trfiladelfo/tm4c123g-communication-expansion-board/FW/Eclipse_Workspace/CAN_drv_multipleRX_example/ReadME.txt

Eclipse and GNU-Tools for ARM Embedded processors are set following the readings below properly modified to work with EK-TM4C123GXL:

1-http://kernelhacks.blogspot.it/2012/11/the-complete-tutorial-for-stellaris.html
2-http://kernelhacks.blogspot.it/2012/11/the-complete-tutorial-for-stellaris_23.html
3-http://kernelhacks.blogspot.it/2012/11/the-complete-tutorial-for-stellaris_25.html

OCD is set following also this reading:

4-http://processors.wiki.ti.com/index.php/Stellaris_Launchpad_with_OpenOCD_and_Linux
