trfiladelfo/tm4c123g-communication-expansion-board/Kicad_Manuals/BYOBGettingStartedPack/Design/BoosterPack_considerations.PNG

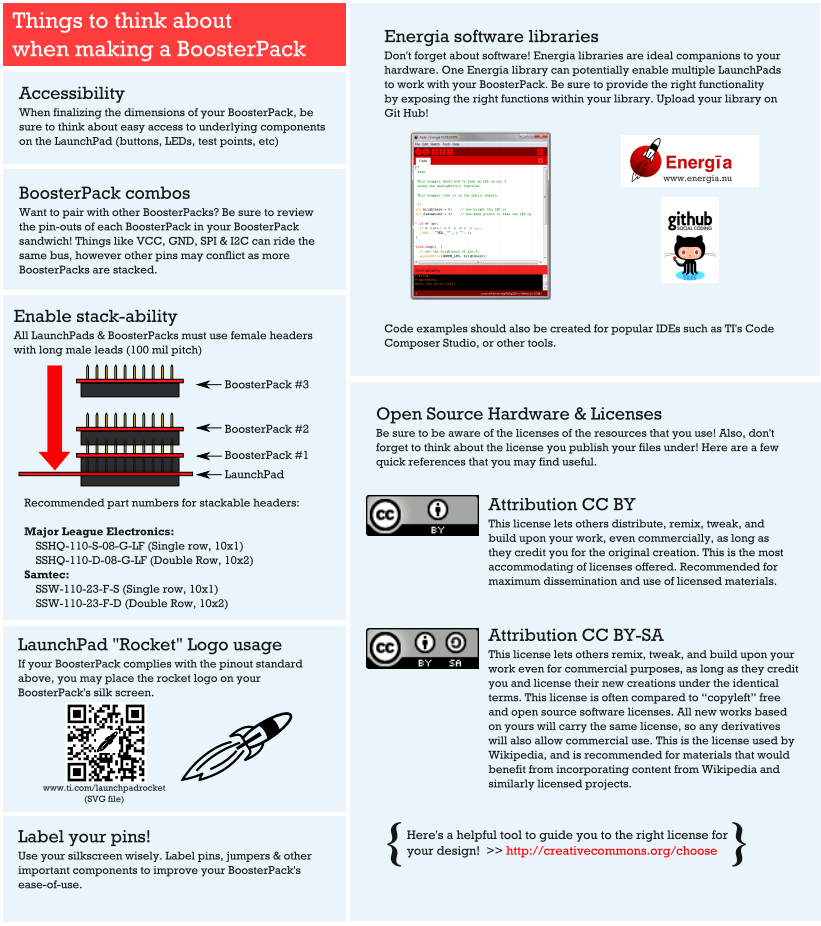
Kicad_Manuals/BYOBGettingStartedPack/Design/BoosterPack_considerations.PNG
