trfiladelfo/tm4c123g-communication-expansion-board/Kicad_Manuals/BYOBGettingStartedPack/Design/BoosterPack_Standard.png

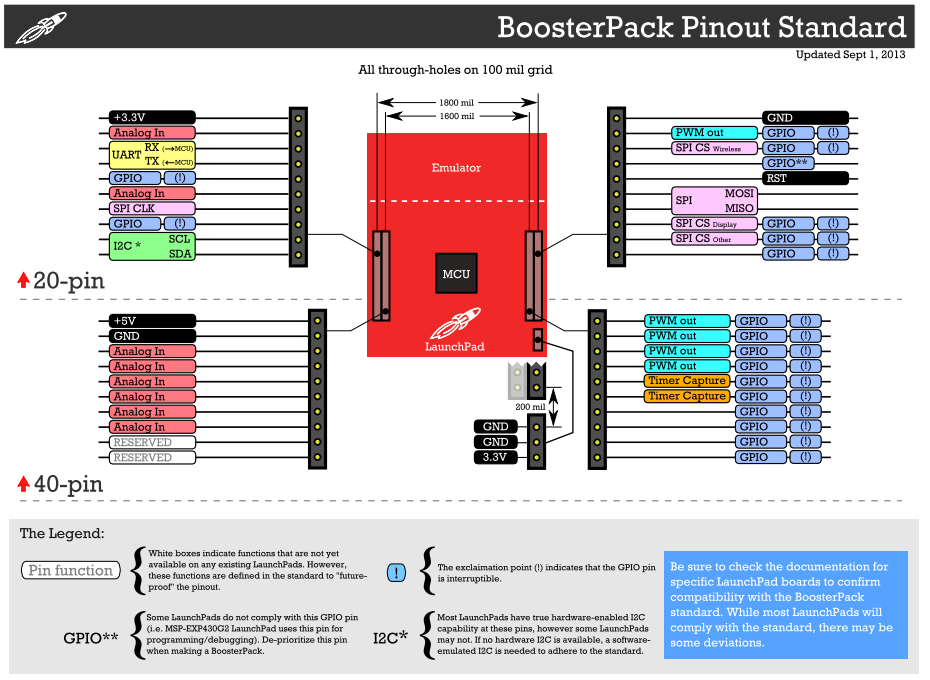
Kicad_Manuals/BYOBGettingStartedPack/Design/BoosterPack_Standard.png
