trfiladelfo/tm4c123g-communication-expansion-board/Kicad_Manuals/BYOBGettingStartedPack/Design/BOM Template and Examples/PCB Assembly Express BOM.XLS

 |  |  | Bill of Materials
 | Customer Project Name:
 | Quote Number:
 | Date
 | Customer Name
 | Company
 | Address 1
 | Address 2
 | City
 | State
 | Zip code
Item | Qty | Reference | Description | Footprint | Type | Manufacturer | Manufacturer Part # | PCB AE Supplies | Vendor | Vendor Part # | Availibility | Min Order Quantity | Order Quantity | Price Each | Ext Price |  | price each | ext price
 |  |  |  |  |  |  |  |  |  |  |  |  |  |  | 0
 |  |  |  |  |  |  |  |  |  |  |  |  |  |  | 0
 |  |  |  |  |  |  |  |  |  |  |  |  |  |  | 0
 |  |  |  |  |  |  |  |  |  |  |  |  |  |  | 0
 |  |  |  |  |  |  |  |  |  |  |  |  |  |  | 0
 |  |  |  |  |  |  |  |  |  |  |  |  |  |  | 0
 |  |  |  |  |  |  |  |  |  |  |  |  |  |  | 0
 |  |  |  |  |  |  |  |  |  |  |  |  |  |  | 0
 |  |  |  |  |  |  |  |  |  |  |  |  |  |  | 0
 |  |  |  |  |  |  |  |  |  |  |  |  |  |  | 0
 |  |  |  |  |  |  |  |  |  |  |  |  |  |  | 0
 |  |  |  |  |  |  |  |  |  |  |  |  |  |  | 0
 |  |  |  |  |  |  |  |  |  |  |  |  |  |  | 0
 |  |  |  |  |  |  |  |  |  |  |  |  |  |  | 0
 |  |  |  |  |  |  |  |  |  |  |  |  |  |  | 0
 |  |  |  |  |  |  |  |  |  |  |  |  |  |  | 0
 |  |  |  |  |  |  |  |  |  |  |  |  |  |  | 0
 |  |  |  |  |  |  |  |  |  |  |  |  |  |  | 0
 |  |  |  |  |  |  |  |  |  |  |  |  |  |  | 0
 |  |  |  |  |  |  |  |  |  |  |  |  |  |  | 0
 |  |  |  |  |  |  |  |  |  |  |  |  |  |  | 0
 |  |  |  |  |  |  |  |  |  |  |  |  |  |  | 0
 |  |  |  |  |  |  |  |  |  |  |  |  |  |  | 0
 |  |  |  |  |  |  |  |  |  |  |  |  |  |  | 0
end
 |  |  |  |  |  |  |  |  |  |  |  |  |  |  | 0
 | Board Totals
 |  | 0 | Total Line Items
 |  | 0 | SMT
 |  | 0 | Thru-hole
 |  | 0 | Fine Pitch
 |  | 0 | BGA
 |  | 0 | Do Not Stuff
 |  | 0 | Total Parts Placements
 | Footprint Key:
 | smt | Surface Mount Technology parts
 | fine | Fine pitch parts
 | bga | Ball Grid Array or orher parts requiring X-Ray inspection
 | thru | Thru-Hole technology parts
 | dns | Do not stuff
 | For Kitted projects columns A-F are required
 | For Partial Kitted projects column I is required
 | For Turn-Key or Partial Kitted projects columns G&H or J&K are also required
 |  |  |  |  |  |  |  |  |  |  |  |  |  |  |  | 0.00
 |  |  |  |  |  |  |  |  |  |  |  |  |  |  |  | 0
