trfiladelfo/tm4c123g-communication-expansion-board/Kicad_Manuals/BYOBGettingStartedPack/Design/BOM Template and Examples/40-Pin-LaunchPad-BoosterPack-Template.csv

Reference | Description | Quantity
J1/J3 J4/J2 |  | 2
