trfiladelfo/tm4c123g-communication-expansion-board/KiCAD_ExpansionBoard/LaunchPad_Logo/LaunchPad_Rocket.pdf

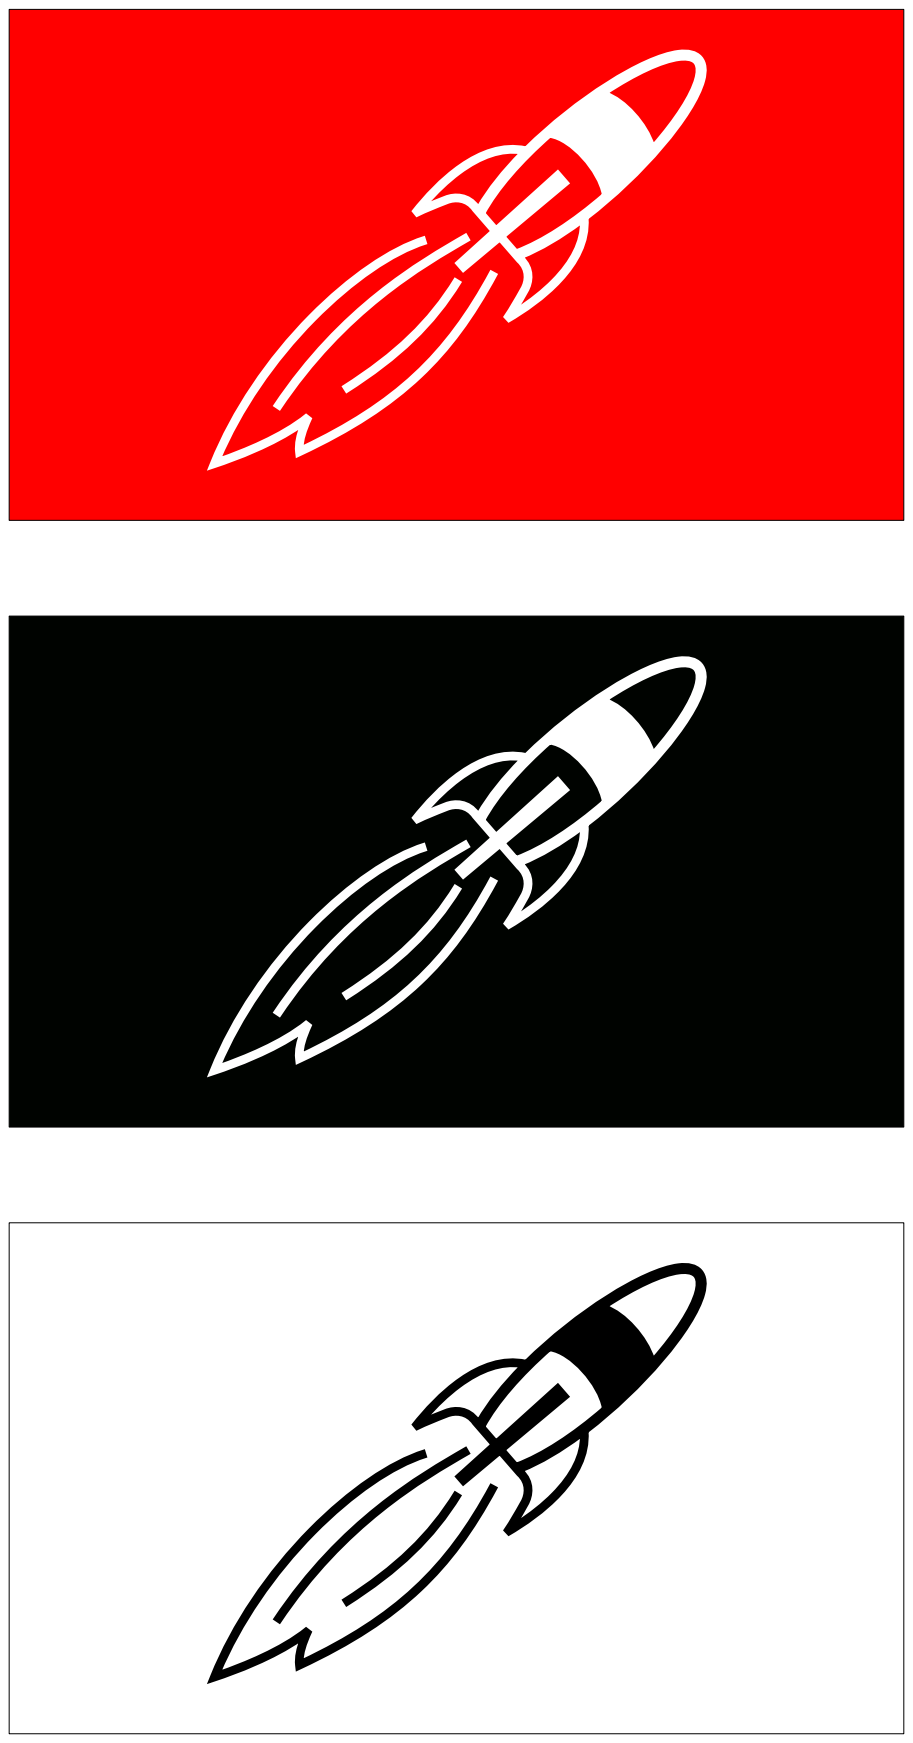
[picture p95: page 1]
