trfiladelfo/tm4c123g-communication-expansion-board/Kicad_Manuals/BYOBGettingStartedPack/Design/BoosterPack_Standard_PUBLIC_2PAGE.pdf

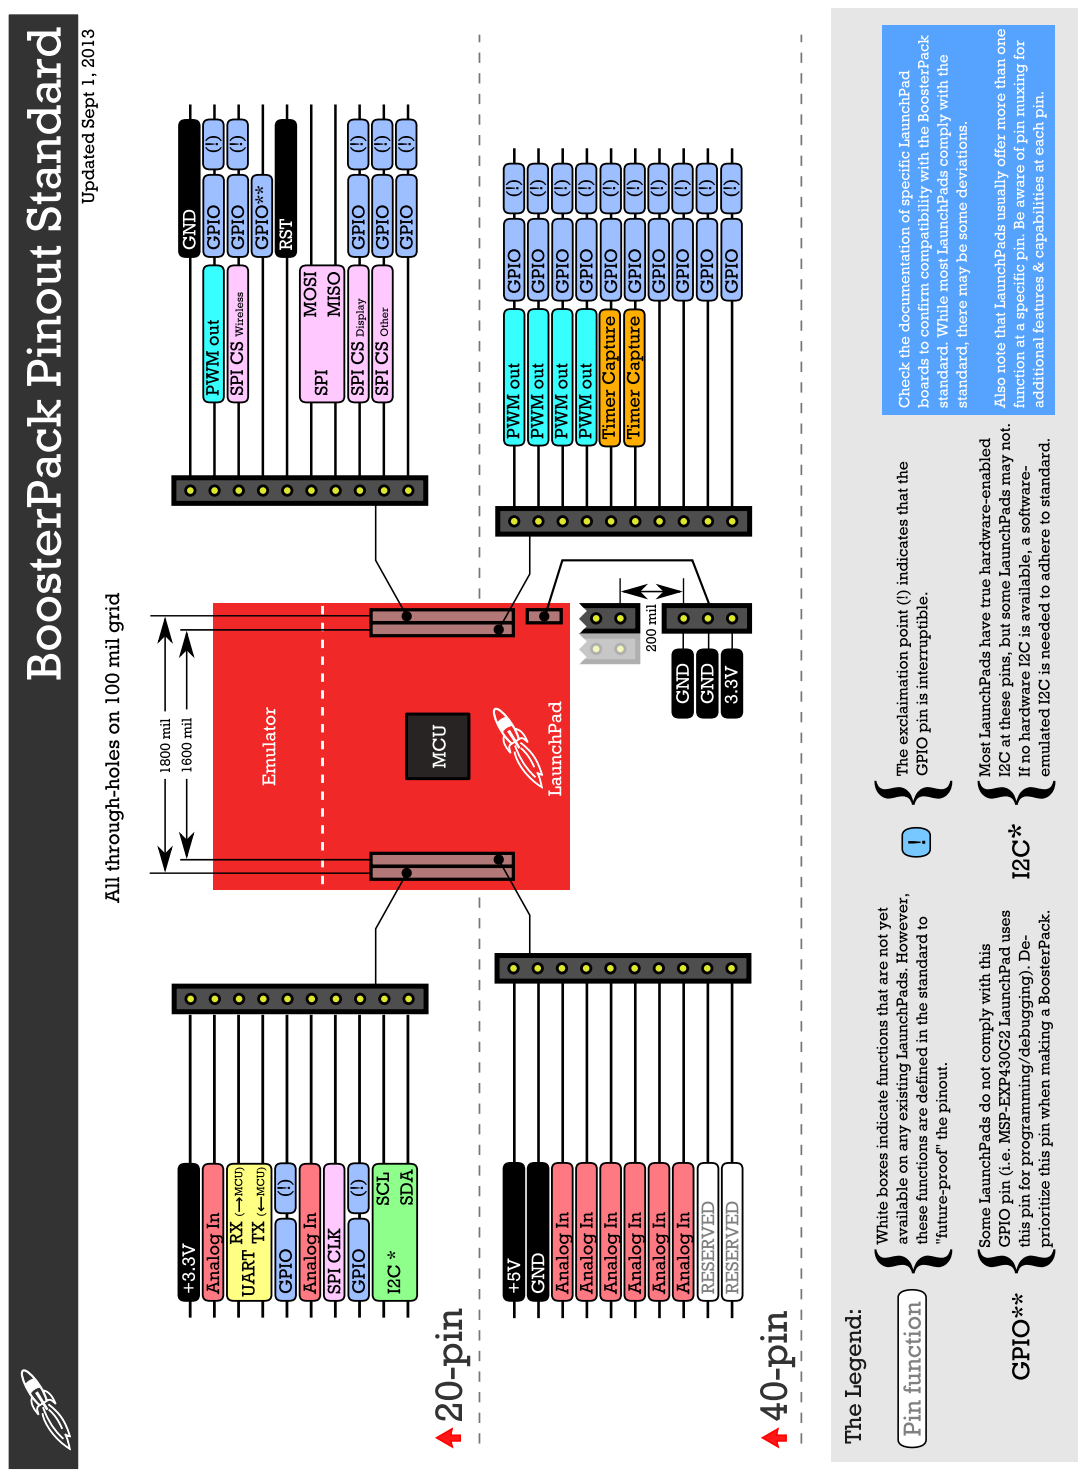
[picture p96: page 1]

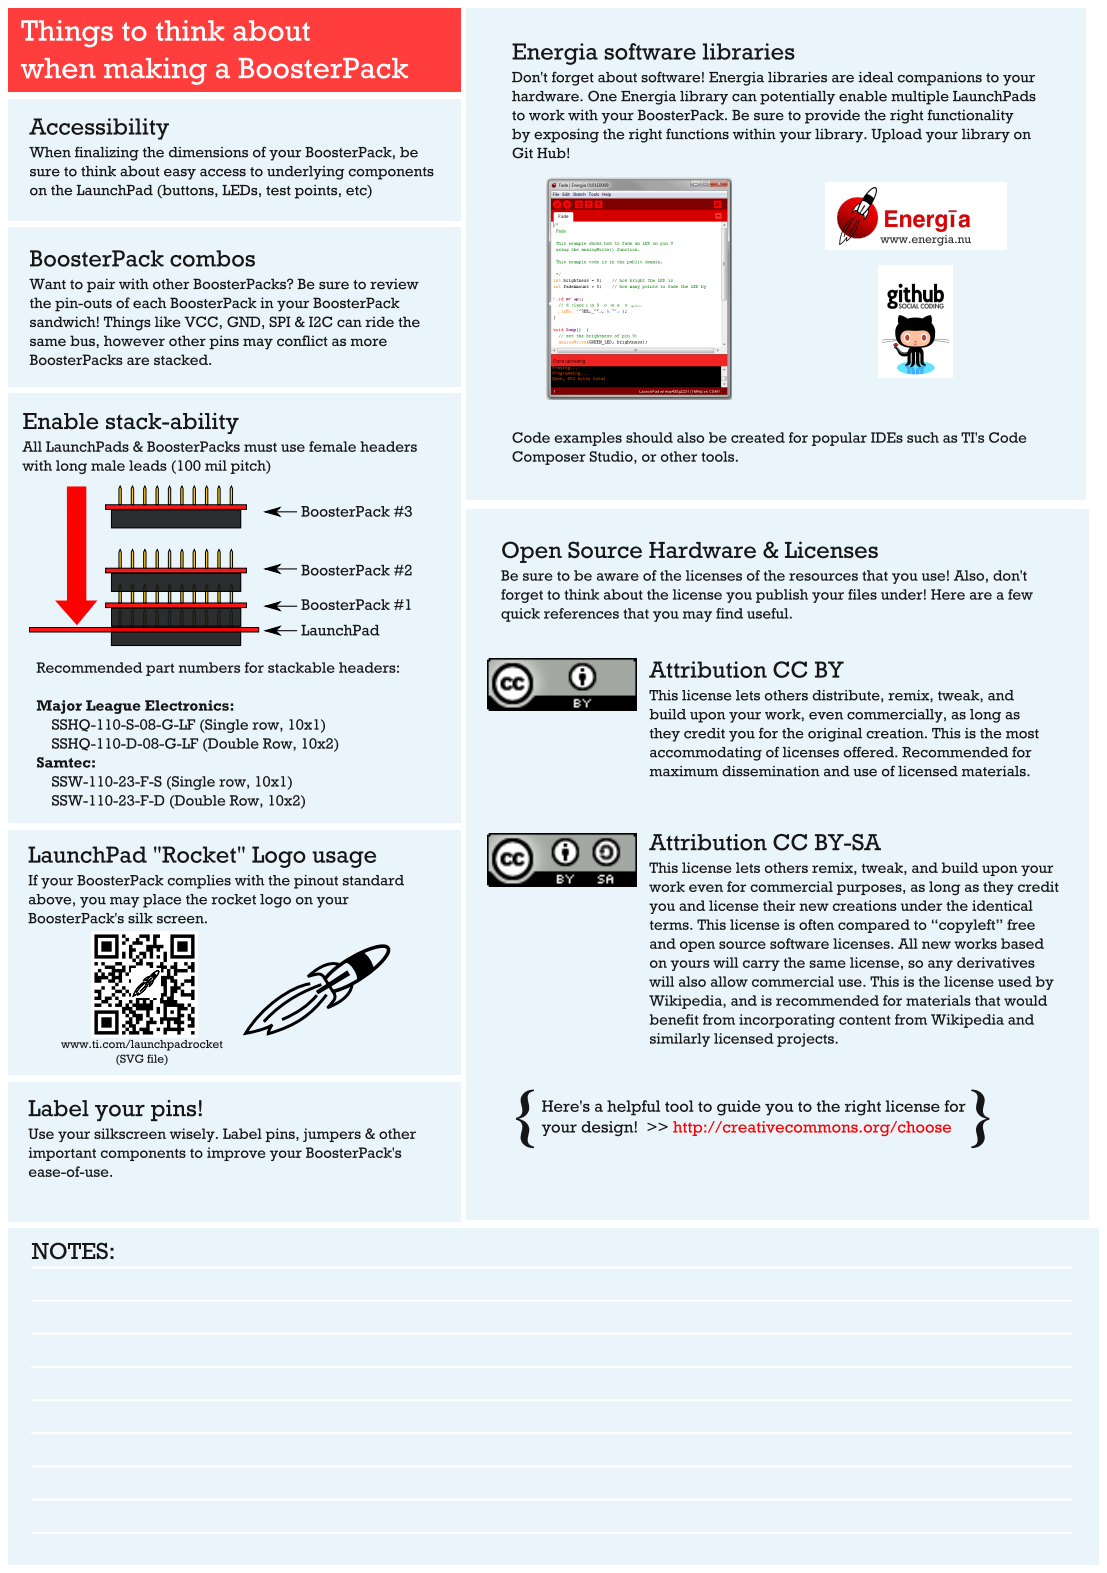
[picture p97: page 2]
