trfiladelfo/tm4c123g-communication-expansion-board/ADC/AN_MONITOR_antialiasing_RC.asc

C1: cap; 10n
R1: res; 10k
R2: res; 1MEG
R3: res; {Rd}
V1: voltage; 20.48; AC 1
Named nets: 0
.ac oct 1000 1 100k
.step param Rd 1k 3k
.param Rd 1.91k
.op
