trfiladelfo/tm4c123g-communication-expansion-board/ADC/antialiasing_filter.asc

C1: cap; 1n
R1: res; 22
R2: res; 1G
V1: voltage; ""; AC 1
Named nets: 0, ADC_in
.ac oct 1000 1 100MEG
