trfiladelfo/tm4c123g-communication-expansion-board/RS485/FailSafe_biasing_sim/FailSafe_biasing_sim_Rfs.asc

R1: res; {Rfs}
R2: res; 120
R3: res; {Rfs}
V1: voltage; 3.3
Named nets: 0, A, B
.step param Rfs 500 2000 100
.op
Per avere una polarizzazione di VAB=100mV, occorre usare Rfs=1722 ohm
per una polarizzazione di VAB=200mV, usare una Rfs=833 ohm
