trfiladelfo/tm4c123g-communication-expansion-board/Power_Supply/LTSPICE_PS_SIM/LT3502_BakCurrentProtection.asc

B1: bv; V=V(G1)*0.66
C2: cap; 22µ
C3: cap; .1µ
D1: schottky; MBR0520L
L1: ind; 15µ
M1: pmos; FDS4465
Q1: npn; QPDTC124XT
R1: res; 22k
R2: res; 31.6K
R3: res; 10K
R4: res; 6.6
R5: res; 10k
R6: res; 47k
R7: res; 10k
SW1: sw; MySwitch
U1: LT3502
V1: voltage; 12
Vbus: voltage; 12
Vcc: voltage; PULSE(0 5 0 10u 10u 1m 2m)
Named nets: 0, OUT, IN, G1, D1, Vbus
.tran 7.2m startup
.model MySwitch SW(Ron=.0001 Roff=1000Meg Vt=1.5 Vh=.000001 Lser=0.001 Vser=0)
*
**********************************************************
*
* PDTC124XT 
*
* NXP Semiconductors
*
* Resistor equipped NPN transistor (RET)
* IC   = 100 mA
* VCEO = 50 V 
* hFE  = min. 80 @ 5V/5mA
* R1   = 22 Kohm
* R2   = 47 Kohm
*
*
* Package pinning does not match Spice model pinning.
* Package: SOT 23
* 
* Package Pin 1: Base 
* Package Pin 2: Emitter
* Package Pin 3: Collector 
*
*
* Extraction date (week/year): 30/2003
* Simulator: Spice 3
*
**********************************************************
*#
* Please note: Resistances R1 and R2 are not part of the 
* model and have to be added separately.
*
.MODEL QPDTC124XT NPN
+ IS = 1.822E-14 
+ NF = 0.9932 
+ ISE = 2.894E-16 
+ NE = 1.4 
+ BF = 354.4 
+ IKF = 0.246 
+ VAF = 182 
+ NR = 0.9931 
+ ISC = 9.982E-12 
+ NC = 1.763 
+ BR = 14.99 
+ IKR = 0.05
+ VAR = 17.9 
+ RB = 10 
+ IRB = 5E-06 
+ RBM = 5 
+ RE = 0.649 
+ RC = 1.101 
+ XTB = 0 
+ EG = 1.11 
+ XTI = 3 
+ CJE = 1.32E-11 
+ VJE = 0.8401 
+ MJE = 0.3622 
+ TF = 1E-32 
+ XTF = 0 
+ VTF = 1E+03 
+ ITF = 0 
+ PTF = 0 
+ CJC = 3.821E-12 
+ VJC = 0.5986 
+ MJC = 0.3745 
+ XCJC = 0.6193 
+ TR = 1E-32
+ CJS = 0 
+ VJS = 0.75 
+ MJS = 0.333 
+ FC = 0.5
*##
*
