trfiladelfo/tm4c123g-communication-expansion-board/Power_Supply/LTSPICE_PS_SIM/BackCurrent_PMOS_sim.asc

3V3_LP: bv; V=V(G)*0.66
5V_LP: voltage; PULSE(0 5 0 10n 10n 100m 200m 100)
M1: pmos; FDS4465
R1: res; 1k
R2: res; 100k
R3: res; 100k
V1: voltage; {Vreg}; Rser=1
Named nets: 0, S, G, out
.tran 0 560m 0
.step param Vreg list 0 3.4
.param Vreg 3.4
