trfiladelfo/tm4c123g-communication-expansion-board/Power_Supply/LTSPICE_PS_SIM/ReverseCurrent&TVS_PowerSupplyIn_PMOS.asc

M1: pmos; FDC638P
R1: res; 80
R2: res; 10
TVS: zener; SMAJ12A
V1: voltage; 1
Named nets: 0, out
.dc V1 -100 200
.SUBCKT SMAJ12A      1   2
*       TERMINALS:   A   K
Done    1            2   Dtvs
Rleak   1            2   24meg
.MODEL  Dtvs         D   (IS=1.0e-5 RS=0.2127 N=1.5 IBV=10m BV=13.43 CJO=1400p)
.ENDS
