trfiladelfo/tm4c123g-communication-expansion-board/Power_Supply/LTSPICE_PS_SIM/ESD protection/IEC61000-4-2_ESD_Generator.asc

C1: cap; 150p
C2: cap; 8p
L1: ind; 2.4µ
L2: ind; 140n
R1: res; 330
R2: res; 200
S2: sw
S3: sw
V1: voltage; PULSE(0 1 {td} 1f 1 1 2)
Named nets: 0, c1, c2, ESD, GND
.model SW SW(Ron=1 Roff=1G Vt=0.5)
.ic V(c1)=nom_voltage V(c2)=nom_voltage
IEC 61000-4-2 based ESD Generator
.param nom_voltage=IEC61000_4_2_test_level*2000
.param IEC61000_4_2_test_level=1 td=1p
IEC61000-4-2_ESD_Generator.asc by Luca Buccolini is licensed under a Creative Commons Attribution-ShareAlike 4.0 International License.
http://creativecommons.org/licenses/by-sa/4.0/
IEC61000-4-2 Test levels:
#######################
Contact discharge         
#######################
Level  #  Test voltage   
#######################
#     1    #      2 kV         
#     2    #      4 kV         
#     3    #      6 kV         
#     4    #      8 kV         
#     X    #     Special     
#######################
 
Change IEC_61000-4-2_test_level to chose relative Test voltage. 
The default is level 1.
 
Change td to set a custom ESD unleashed time.
The default value of td is 1ps.
 
To change these parameters edit the string:
.param IEC61000_4_2_test_level=1 td=1p
replacing 1 and 1p with desired values.
