trfiladelfo/tm4c123g-communication-expansion-board/Power_Supply/LTSPICE_PS_SIM/ESD protection/Pmos_ESD_protection.asc

C3: cap; {Cp}
R3: res; {10m+(120p/X)}
R4: res; 1k
R5: res; {1m+(120*X)}
U1: Xtransil_ST_BI
U2: xpmos
V1: voltage; 3.3
X1: IEC61000-4-2_ESD_Generator; IEC61000_4_2_test_level=1 td=1p
Named nets: 0, gate, ESD, TVS
.param Cp=1e-30
.step param X list 1p 1
.tran 150n
.SUBCKT ESD5B50T1G 1 3
*******************************************
* Model Generated by ON Discrete Eval Lab *
*    Copyright(c) ON Semiconductor        *
*         All Rights Reserved             *
*      UNPUBLISHED LICENSED SOFTWARE      *
*     Contains Proprietary Information    *
*                                         *
*   Commercial Use or Resale Restricted   *
*******************************************
* Model generated on Oct. 27, 06
* MODEL FORMAT: PSpice
*       in   out   
*node:  1    3    
*
X1    1   2    ESD5B50T1G-Z 
X2    3   2    ESD5B50T1G-Z 
*
.ENDS ESD5B50T1G 
*
 
.SUBCKT ESD5B50T1G-Z 7 1
**************************************
*      Model Generated by MODPEX     *
*Copyright(c) Symmetry Design Systems*
*         All Rights Reserved        *
*    UNPUBLISHED LICENSED SOFTWARE   *
*   Contains Proprietary Information *
*      Which is The Property of      *
*     SYMMETRY OR ITS LICENSORS      *
*Commercial Use or Resale Restricted *
*   by Symmetry License Agreement    *
**************************************
* Model generated on Oct 27, 06
* MODEL FORMAT: PSpice
*     anode cathode
*node: 7      1
*    Forward Section
D1 2 1 MDD1
.MODEL MDD1 D IS=3.10113e-13 N=1 XTI=1 RS=0.2
+ CJO=6.24e-11 TT=1e-08
*    Leakage Current
R 1 2 MDR 208333
.MODEL MDR RES TC1=0 TC2=0
*    Breakdown
RZ 2 3 0.751274 
D3 4 3 MDD3
.MODEL MDD3 D IS=2.5e-15 N=0.5 
EV1 1 4 6 8 1
IBV 0 6 0.001
RBV 6 0 MDRBV 6380
.MODEL MDRBV RES TC1=0
D4 8 0 MDD3
L 7 2 1e-15
IT 0 8 0.001
.ENDS ESD5B50T1G-Z
.SUBCKT ntr4101pt1 1 2 3
**************************************
*      Model Generated by MODPEX     *
*Copyright(c) Symmetry Design Systems*
*         All Rights Reserved        *
*    UNPUBLISHED LICENSED SOFTWARE   *
*   Contains Proprietary Information *
*      Which is The Property of      *
*     SYMMETRY OR ITS LICENSORS      *
*Commercial Use or Resale Restricted *
*   by Symmetry License Agreement    *
**************************************
* Model generated on Oct 21, 03
* MODEL FORMAT: PSpice
* Symmetry POWER MOS Model (Version 1.0)
* External Node Designations
* Node 1 -> Drain
* Node 2 -> Gate
* Node 3 -> Source
M1 9 7 8 8 MM L=100u W=100u
* Default values used in MM:
* The voltage-dependent capacitances are
* not included. Other default values are:
*   RS=0 RD=0 LD=0 CBD=0 CBS=0 CGBO=0
.MODEL MM PMOS LEVEL=1 IS=1e-32
+VTO=-0.804818 LAMBDA=0 KP=14.9605
+CGSO=5.82706e-06 CGDO=4.54024e-07
RS 8 3 0.0433803
D1 1 3 MD
.MODEL MD D IS=5.6864e-08 RS=0.0814954 N=1.5 BV=20
+IBV=0.00025 EG=1.2 XTI=4 TT=0.0001
+CJO=1.73869e-10 VJ=0.5 M=0.694913 FC=0.5
RDS 3 1 3.2e+10
RD 9 1 0.0001
RG 2 7 6.27142
D2 5 4 MD1
* Default values used in MD1:
*   RS=0 EG=1.11 XTI=3.0 TT=0
*   BV=infinite IBV=1mA
.MODEL MD1 D IS=1e-32 N=50
+CJO=3.84798e-10 VJ=0.5 M=0.857873 FC=1e-08
D3 5 0 MD2
* Default values used in MD2:
*   EG=1.11 XTI=3.0 TT=0 CJO=0
*   BV=infinite IBV=1mA
.MODEL MD2 D IS=1e-10 N=1.00001 RS=3.00009e-06
RL 5 10 1
FI2 7 9 VFI2 -1
VFI2 4 0 0
EV16 10 0 9 7 1
CAP 11 10 1.76851e-09
FI1 7 9 VFI1 -1
VFI1 11 6 0
RCAP 6 10 1
D4 6 0 MD3
* Default values used in MD3:
*   EG=1.11 XTI=3.0 TT=0 CJO=0
*   RS=0 BV=infinite IBV=1mA
.MODEL MD3 D IS=1e-10 N=1.00001
.ENDS ntr4101pt1
