trfiladelfo/tm4c123g-communication-expansion-board/KiCAD_ExpansionBoard/TM4C123G_CommExpBoard.kicad_pcb

## KiCad design KiCAD_ExpansionBoard/TM4C123G_CommExpBoard.kicad_pcb (2014-11-26)

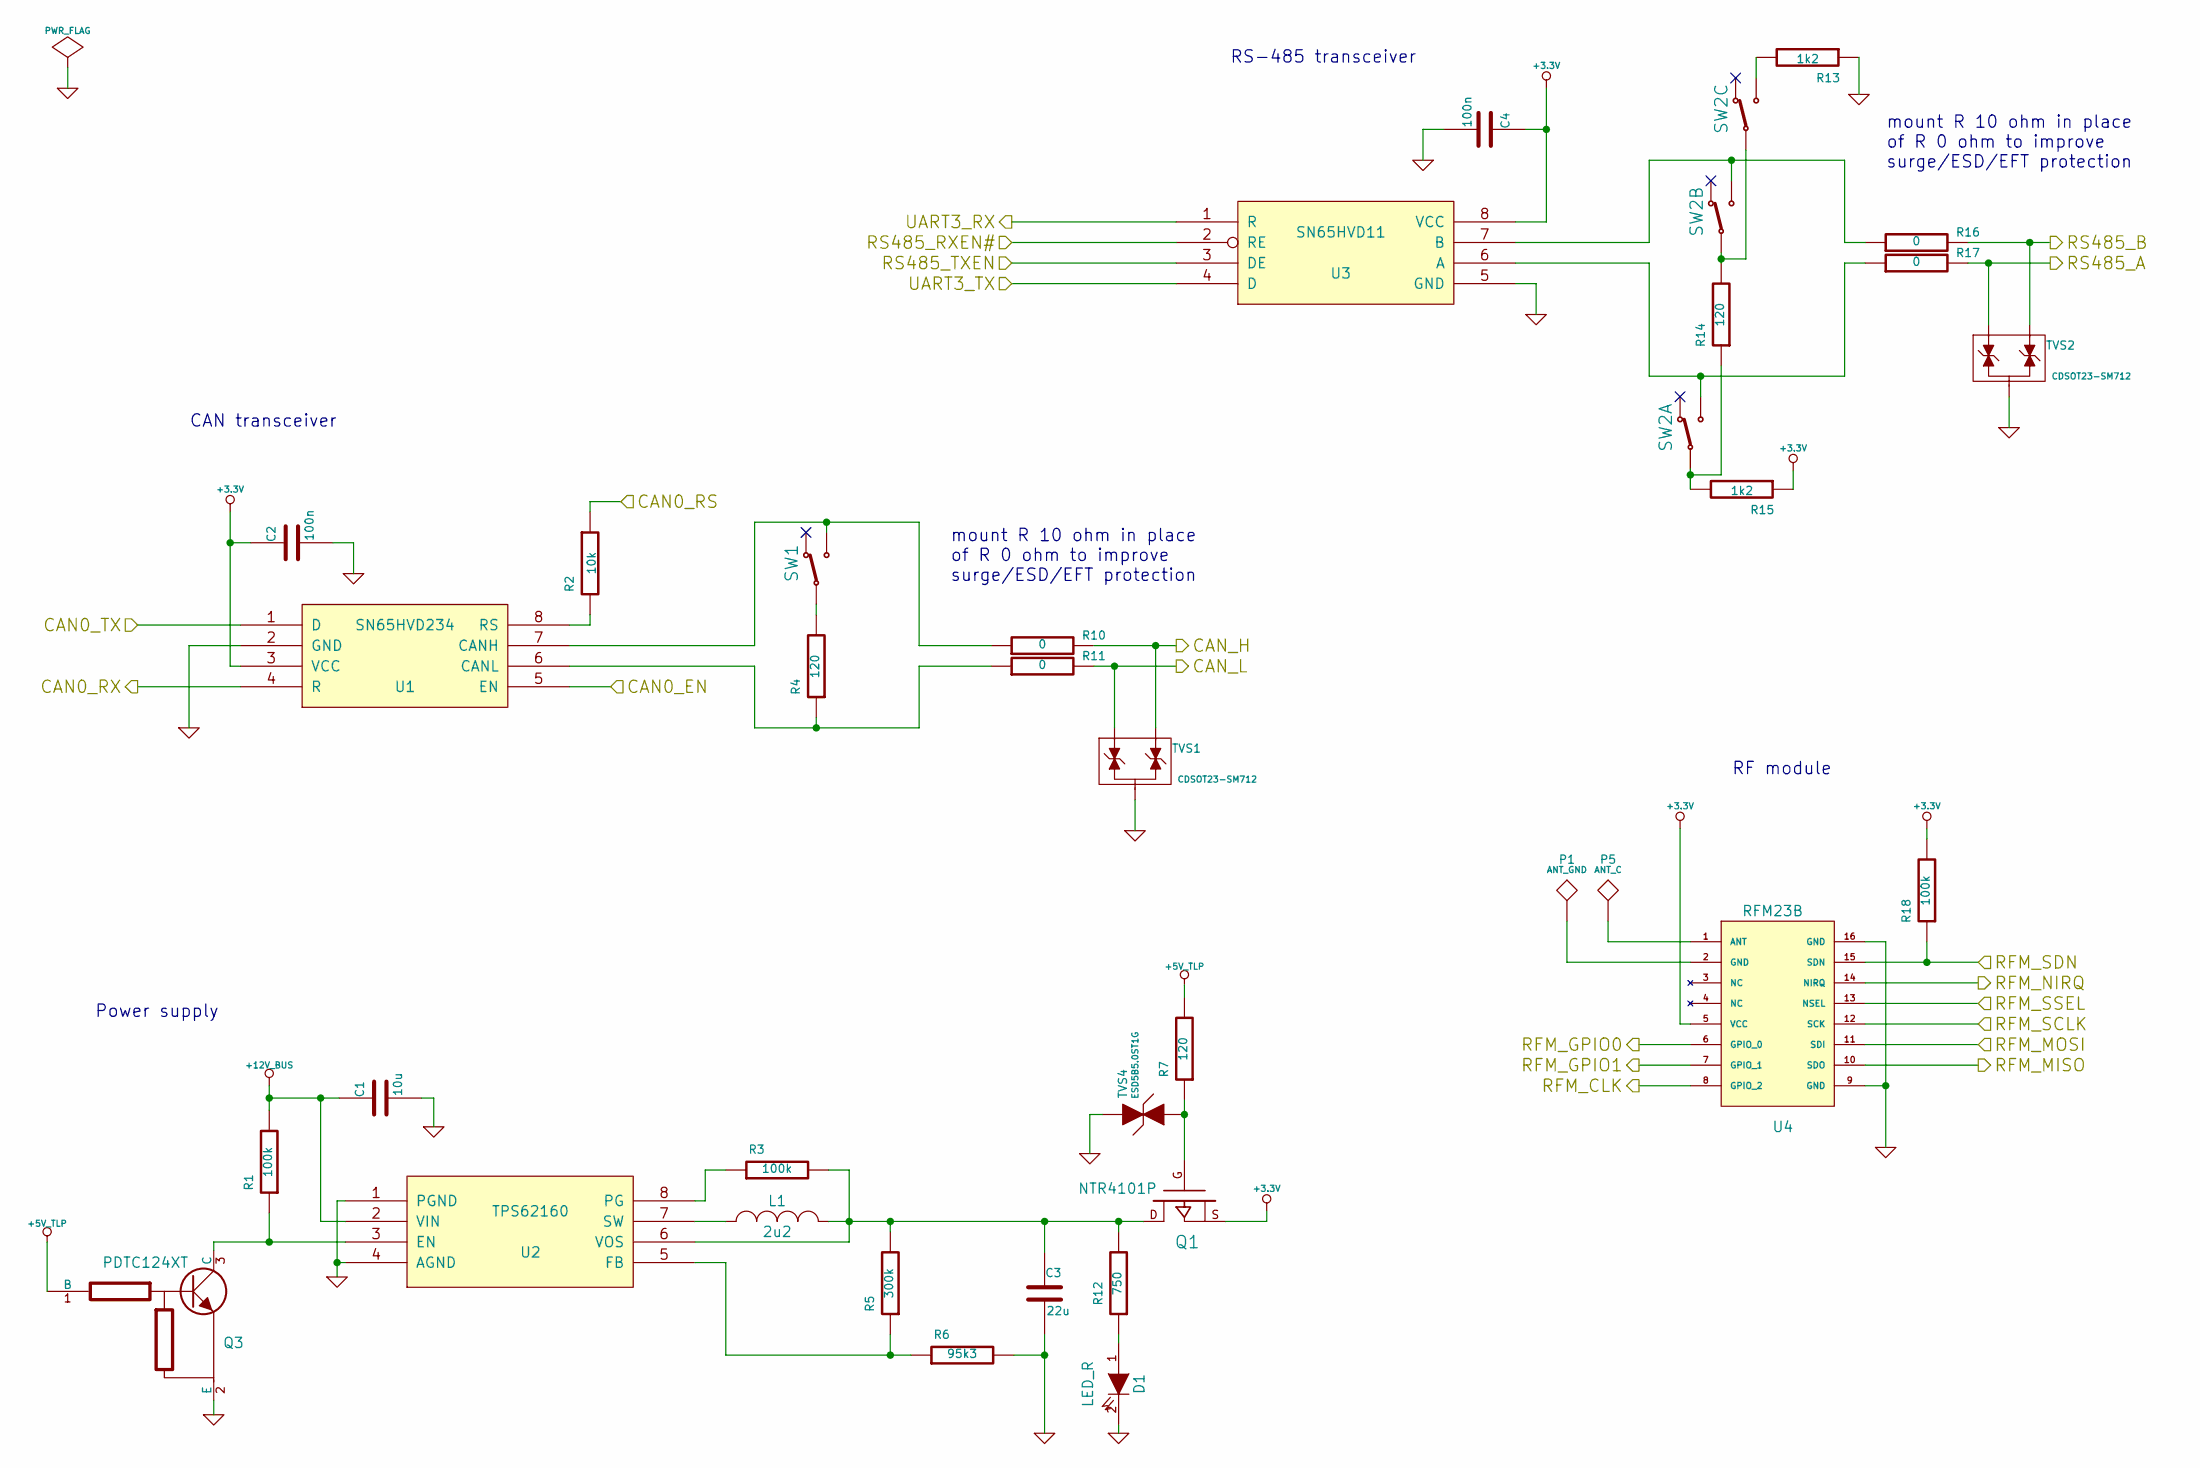
[picture p98: schematic Expansion_board.sch, TM4C123G Communication Expansion Board]

Parts:
C1: 10u
C2, C4: 100n
C3: 22u
D1: LED_R; SM_0603_MD
L1: 2u2
P1: ANT_GND
P5: ANT_C
Q1: NTR4101P
Q3: PDTC124XT; SOT23_MD
R1, R3, R18: 100k
R2: 10k
R4, R7, R14: 120
R5: 300k
R6: 95k3
R10, R11, R16, R17: 0
R12: 750
R13, R15: 1k2
SW1: SLIDE_SWITCH_SPDT
SW2: SLIDE_SWITCH_4PDT
TVS1, TVS2: CDSOT23-SM712
TVS4: ESD5B5.0ST1G; SOD-523_MD
U1: SN65HVD234; MODULE
U2: TPS62160; MODULE
U3: SN65HVD11; MODULE
U4: RFM23B

Connections:
+3.3V: C2.1, C4.1, Q1.S, R15.1, R18.2, U1.3 (VCC), U3.8 (VCC), U4.5 (VCC); also elsewhere on the board
+5V_TLP: Q3.1 (B), R7.2; also elsewhere on the board
+12V_BUS: C1.1, R1.2, U2.2 (VIN); also elsewhere on the board
/Expansion Board/CAN0_EN: U1.5 (EN); also elsewhere on the board
/Expansion Board/CAN0_RS: R2.1; also elsewhere on the board
/Expansion Board/CAN0_RX: U1.4 (R); also elsewhere on the board
/Expansion Board/CAN0_TX: U1.1 (D); also elsewhere on the board
/Expansion Board/CAN_H: R10.2, TVS1.2; also elsewhere on the board
/Expansion Board/CAN_L: R11.2, TVS1.1; also elsewhere on the board
/Expansion Board/RFM_CLK: U4.8 (GPIO_2); also elsewhere on the board
/Expansion Board/RFM_GPIO0: U4.6 (GPIO_0); also elsewhere on the board
/Expansion Board/RFM_MISO: U4.10 (SDO); also elsewhere on the board
/Expansion Board/RFM_MOSI: U4.11 (SDI); also elsewhere on the board
/Expansion Board/RFM_NIRQ: U4.14 (NIRQ); also elsewhere on the board
/Expansion Board/RFM_SCLK: U4.12 (SCK); also elsewhere on the board
/Expansion Board/RFM_SDN: R18.1, U4.15 (SDN); also elsewhere on the board
/Expansion Board/RFM_SSEL: U4.13 (NSEL); also elsewhere on the board
/Expansion Board/RS485_A: R17.2, TVS2.1; also elsewhere on the board
/Expansion Board/RS485_B: R16.2, TVS2.2; also elsewhere on the board
/Expansion Board/RS485_RXEN#: U3.2 (RE); also elsewhere on the board
/Expansion Board/RS485_TXEN: U3.3 (DE); also elsewhere on the board
/Expansion Board/UART3_RX: U3.1 (R); also elsewhere on the board
/Expansion Board/UART3_TX: U3.4 (D); also elsewhere on the board
/TM4C123G Connectors/RFM_GPIO0: U4.7 (GPIO_1); also elsewhere on the board
GND: C1.2, C2.2, C3.2, C4.2, D1.2 (K), Q3.2 (E), R6.2, R13.1, TVS1.3, TVS2.3, TVS4.1, U1.2 (GND), U2.1 (PGND), U2.4 (AGND), U3.5 (GND), U4.9 (GND), U4.16 (GND); also elsewhere on the board
unnamed: P1.1, U4.2 (GND)
unnamed: Q3.3 (C), R1.1, U2.3 (EN)
unnamed: R4.2, SW1.2 (COM)
unnamed: R17.1, SW2.3 (P2), U3.6 (A)
unnamed: R13.2, SW2.7 (P2)
unnamed: R5.1, R6.1, U2.5 (FB)
unnamed: R16.1, SW2.6 (P2), U3.7 (B)
unnamed: R4.1, R11.1, U1.6 (CANL)
unnamed: R10.1, SW1.3 (P2), U1.7 (CANH)
unnamed: R2.2, U1.8 (RS)
unnamed: P5.1, U4.1 (ANT)
unnamed: D1.1 (A), R12.1
unnamed: L1.1, U2.7 (SW)
unnamed: C3.1, L1.2, Q1.D, R3.2, R5.2, R12.2, U2.6 (VOS)
unnamed: Q1.G, R7.1, TVS4.2
unnamed: R14.1, R15.2, SW2.2 (COM)
unnamed: R3.1, U2.8 (PG)
unnamed: R14.2, SW2.5 (COM), SW2.8 (COM)

Notes on the sheet:
mount R 10 ohm in place of R 0 ohm to improve surge/ESD/EFT protection
RS-485 transceiver
CAN transceiver
Power supply
RF module

Schematic: TM4C123G_connectors.sch, TM4C123G Communication Expansion Board

Parts:
C5: 10n
C6, C7: 1n
J1: TI_BOOSTER_40_J1
J2: TI_BOOSTER_40_J2
J3: TI_BOOSTER_40_J3
J4: TI_BOOSTER_40_J4
P6: CAN
P7: UART1
P8: RS485
P9: UART2
P10: GPIO0
Q2: TSM3457; SOT-26_MD
R19: 10k
R20: 1k91
R21, R22: 22
R23, R24, R25, R26: 4k7
TVS3: SMCJ12CA; SMC

Connections:
+3.3V: J1.1, P7.6, P9.6, P10.1, R23.1, R24.1, R25.1, R26.1; also elsewhere on the board
+5V_TLP: J3.1; also elsewhere on the board
+12V_BUS: Q2.S, R19.1; also elsewhere on the board
/Expansion Board/CAN0_EN: J2.6; also elsewhere on the board
/Expansion Board/CAN0_RS: J2.7; also elsewhere on the board
/Expansion Board/CAN0_RX: J1.5; also elsewhere on the board
/Expansion Board/CAN0_TX: J1.6; also elsewhere on the board
/Expansion Board/CAN_H: P6.3; also elsewhere on the board
/Expansion Board/CAN_L: P6.2; also elsewhere on the board
/Expansion Board/RFM_CLK: J3.3; also elsewhere on the board
/Expansion Board/RFM_GPIO0: P10.6; also elsewhere on the board
/Expansion Board/RFM_MISO: J2.8; also elsewhere on the board
/Expansion Board/RFM_MOSI: J1.8; also elsewhere on the board
/Expansion Board/RFM_NIRQ: J2.3; also elsewhere on the board
/Expansion Board/RFM_SCLK: J2.10; also elsewhere on the board
/Expansion Board/RFM_SDN: J1.7; also elsewhere on the board
/Expansion Board/RFM_SSEL: J2.9; also elsewhere on the board
/Expansion Board/RS485_A: P8.2; also elsewhere on the board
/Expansion Board/RS485_B: P8.3; also elsewhere on the board
/Expansion Board/RS485_RXEN#: J3.5; also elsewhere on the board
/Expansion Board/RS485_TXEN: J3.6; also elsewhere on the board
/Expansion Board/UART3_RX: J4.6; also elsewhere on the board
/Expansion Board/UART3_TX: J4.7; also elsewhere on the board
/TM4C123G Connectors/+12V_BUS_UNP: P6.1, P8.1, Q2.D, TVS3.1
/TM4C123G Connectors/AIN0: C7.1, J3.9, R22.2
/TM4C123G Connectors/AIN1: C6.1, J3.8, R21.2
/TM4C123G Connectors/EXT_AIN0: P10.3, R22.1
/TM4C123G Connectors/EXT_AIN1: P10.4, R21.1
/TM4C123G Connectors/I2C0_SCL: J2.2, P10.8, R26.2
/TM4C123G Connectors/I2C0_SDA: J4.3, P10.7, R23.2
/TM4C123G Connectors/I2C1_SCL: J1.9, P10.10, R24.2
/TM4C123G Connectors/I2C1_SDA: J1.10, P10.9, R25.2
/TM4C123G Connectors/RFM_GPIO0: P10.5; also elsewhere on the board
/TM4C123G Connectors/UART1_CTS: J4.5, P7.4
/TM4C123G Connectors/UART1_RTS: J4.4, P7.1
/TM4C123G Connectors/UART1_RX: J1.3, P7.5
/TM4C123G Connectors/UART1_TX: J1.4, P7.3
/TM4C123G Connectors/UART2_RST: J3.4, P9.4
/TM4C123G Connectors/UART2_RX: J4.8, P9.5
/TM4C123G Connectors/UART2_TREQ: J1.2, P9.1
/TM4C123G Connectors/UART2_TX: J4.9, P9.3
/TM4C123G Connectors/V_AN_MONITOR: C5.1, J3.7, R19.2, R20.1
GND: C5.2, C6.2, C7.2, J2.1, J3.2, P6.4, P7.2, P8.4, P9.2, P10.2, Q2.G, R20.2, TVS3.2; also elsewhere on the board

Notes on the sheet:
Divider ratio=6.236
I2C: generic pull-up resistor
ADC input: generic anti-aliasing filter
Spare function 5x2 male header
RS-485 connector & power supply rail
CAN connector & power supply rail
UART1 3x2 male header
UART2 3x2 male header
4x Stackable 10 pin headers
Transient & reverse polarity protections of power supply rail

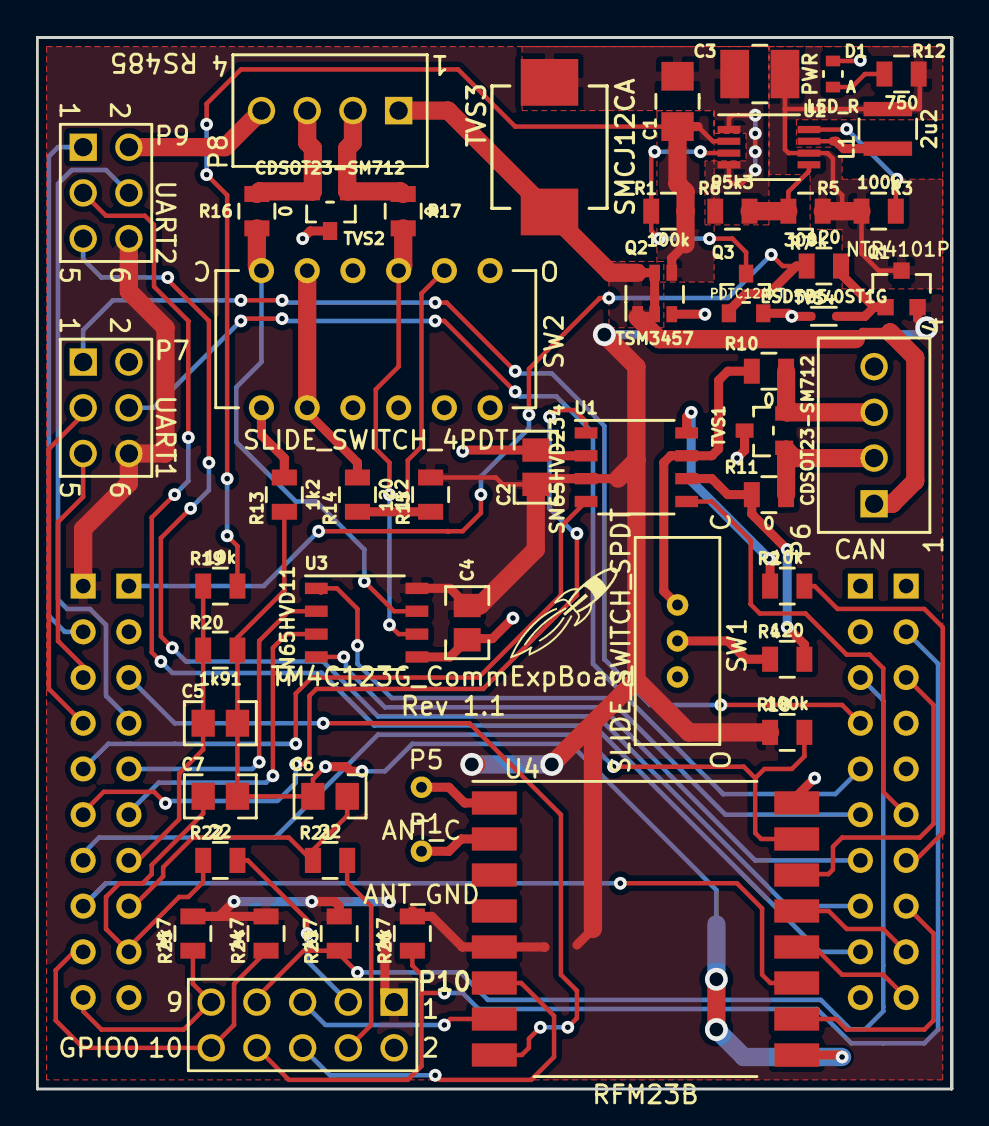
[picture p99: board TM4C123G_CommExpBoard.kicad_pcb from above]

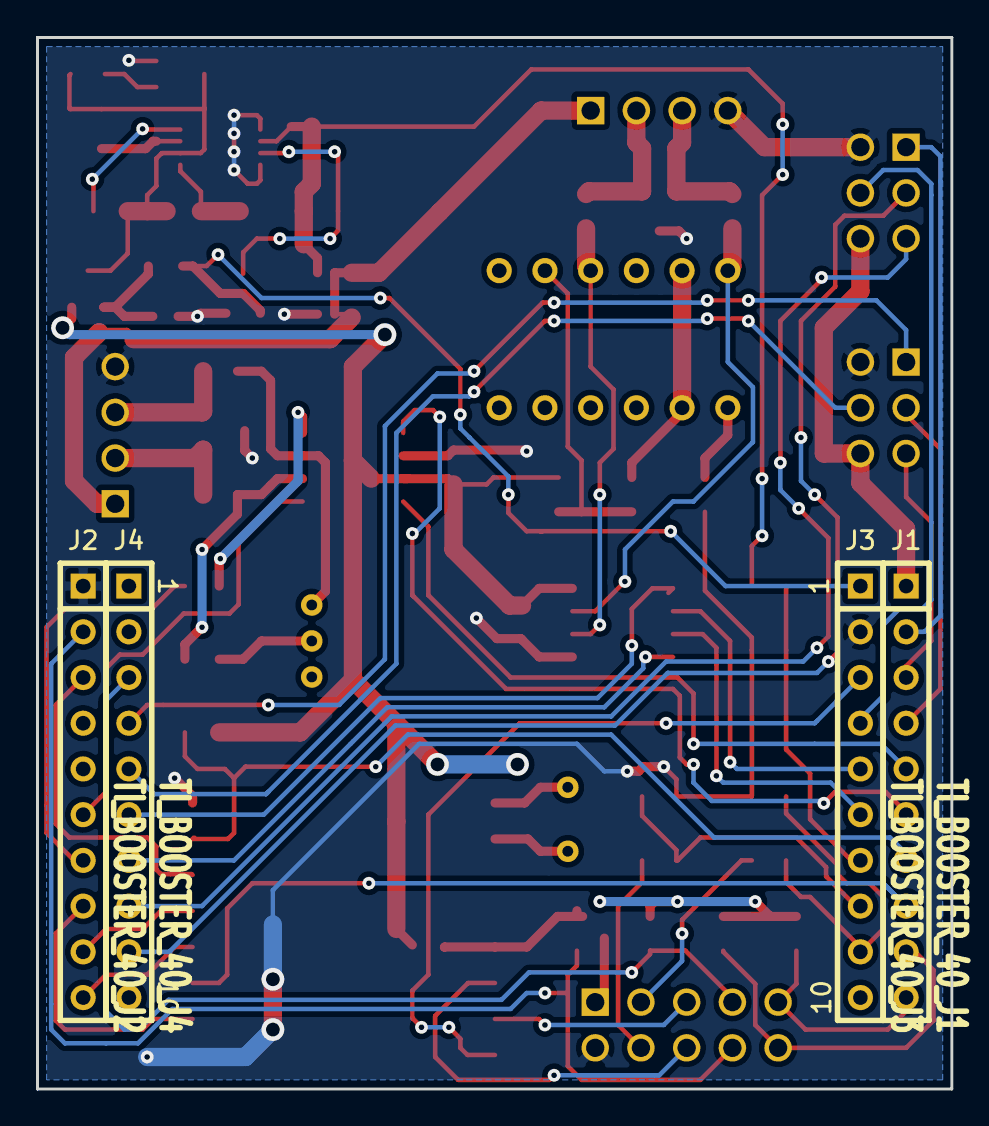
[picture p100: board TM4C123G_CommExpBoard.kicad_pcb from below]

Board: 2 copper layers, 50.8 x 58.4 mm, 58 parts (4 on the bottom side), 61 nets.

Other parts of the board:
G1: LOGO
