trfiladelfo/tm4c123g-communication-expansion-board/Kicad_Manuals/BYOBGettingStartedPack/Design/EAGLE/Circuitco EAGLE BoosterPack template/BoosterPack-Template-revA.sch

## EAGLE design Kicad_Manuals/BYOBGettingStartedPack/Design/EAGLE/Circuitco EAGLE BoosterPack template/BoosterPack-Template-revA.sch (2014-06-09)

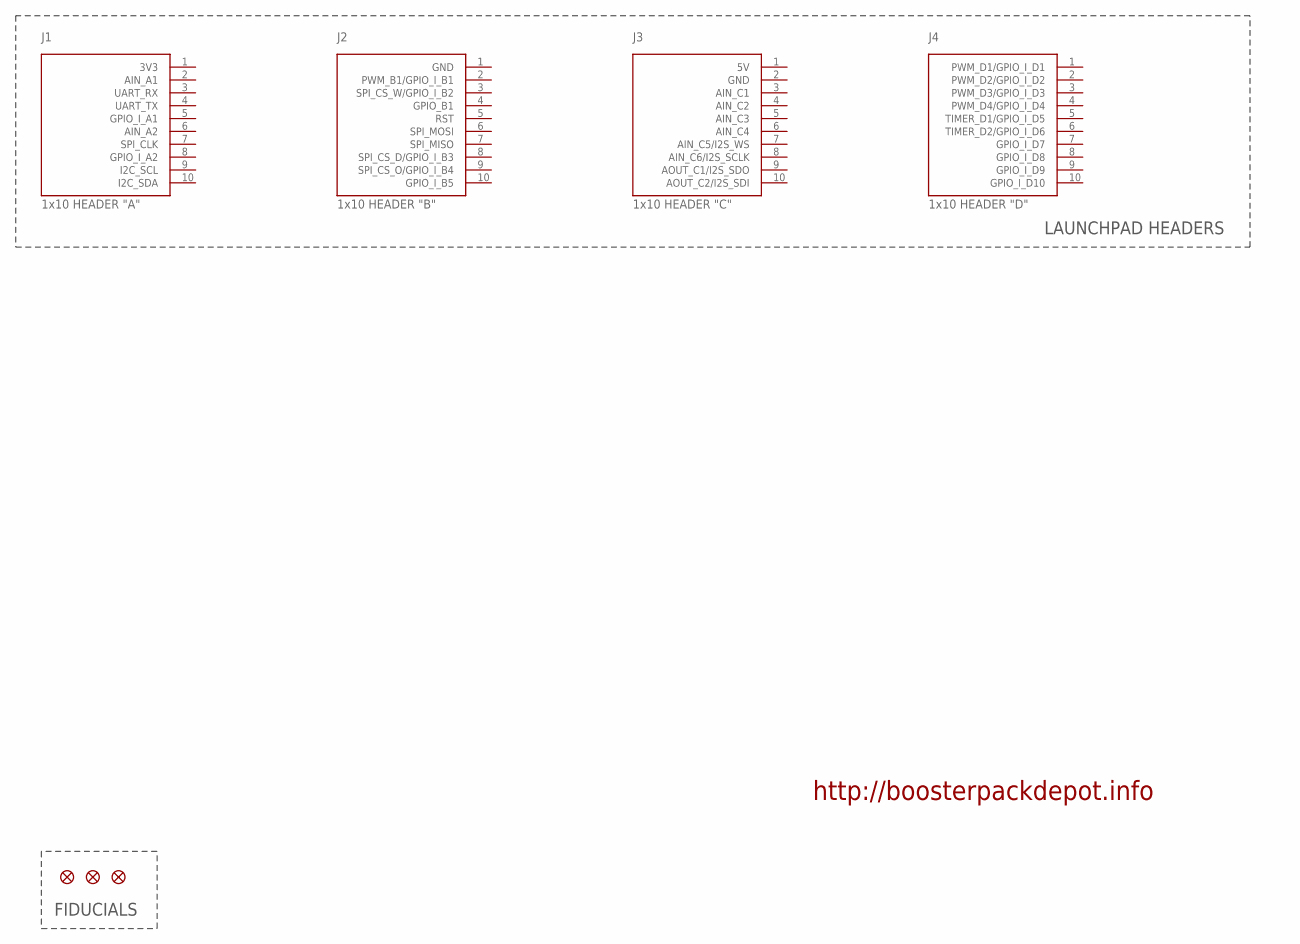
[picture p101: schematic BoosterPack-Template-revA.sch]

Parts:
FID1, FID2, FID3: FIDUCIAL; FIDUCIAL_L10
J1: 1x10 HEADER "A"; 1X10
J2: 1x10 HEADER "B"; 1X10
J3: 1x10 HEADER "C"; 1X10
J4: 1x10 HEADER "D"; 1X10

Notes on the sheet:
LAUNCHPAD HEADERS
FIDUCIALS
http://boosterpackdepot.info
