trfiladelfo/tm4c123g-communication-expansion-board/(commit log)

2014-06-09 Project loaded on Google code. The KiCAD schematic are still empty.
    [40-Pin-LaunchPad-BoosterPack-Template.csv, BYOB-BoosterPack-Template.brd, BYOB-BoosterPack-Template.sch, BoosterPack-Template-revA.brd, BoosterPack-Template-revA.sch, Expansion_board.sch, External_connectors.sch, PCB Assembly Express BOM.XLS]
2014-06-09 Creation of project (sheets) structure and add some library schematic component (transceiver.lib, headers, etc.)
    [Expansion_board.sch, External_connectors.sch, TM4C123G_CommExpBoard.sch, TM4C123G_connectors.sch]
2014-07-01 Circuit board schematic complete! TODO: Update schematic according new received specifics: "note-expansionboard_20140623.txt"
    [Expansion_board.sch, External_connectors.sch, TM4C123G_CommExpBoard.sch, TM4C123G_connectors.sch]
2014-07-03 -Unito le due linee a 3.3V e riposizionato Q1 che ora va ad interrompere la linea di alimentazione a 3.3V dello switching quando è presente la +5V_TLP (USB). In serie al gate ho messo R8 da 120 ohm e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
    -Ho messo un NPN, Q3, che ha al suo interno un partitore da 22k + 47k; è pilotato dalla +5V_TLP ed ho messo R1 verso +12V_BUS che mantiene attivo lo switching a meno che non sia presente la +5V_TLP (Q3 ON). Infine ho posizionato il led a monte del PMOS.
    -Per la protezione dalle sovratensioni sulla +5V_TLP ho inserito, all'ingesso, TVS4 che è bidirezionale con tensione di lavoro a 5V e tensione di breakdown di 5.8V (min).
    -Rimosse tutte le resistenze di pu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
    [Expansion_board.sch, TM4C123G_CommExpBoard.csv, TM4C123G_CommExpBoard.kicad_pcb, TM4C123G_CommExpBoard.sch, TM4C123G_connectors.sch]
2014-07-15 -Eliminata R7> con l-aggiunta di Q3 ora il pull down [ incorporato in esso, un-altro sprecher' solo corrente -Aumentate R1 e R18 a 100k -Modificata la connessione di SW2 per minimizzare la capacit' s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
    [$External_connectors.sch, Expansion_board.sch, External_connectors.sch, TM4C123G_CommExpBoard.sch, TM4C123G_connectors.sch]
2014-07-15 -Aggiunta R7 in serie a monte del TVS4. Se non occorre, sostituire con una 0ohm.
    [Expansion_board.sch, TM4C123G_CommExpBoard.csv, TM4C123G_CommExpBoard.kicad_pcb, TM4C123G_CommExpBoard.sch, TM4C123G_connectors.sch]
2014-08-06 Eliminata R8 e collegata la piazzola P1 direttamente al pin 2 del RFM23B. Schema elettrico alla versione 0.3.3 Cretata la BOM definitiva in (TM4C123G_CommExpBoard_BOM.xlsx e TM4C123G_CommExpBoard.csv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
    [Expansion_board.sch, TM4C123G_CommExpBoard.csv, TM4C123G_CommExpBoard.kicad_pcb, TM4C123G_CommExpBoard.sch, TM4C123G_CommExpBoard_BOM.xlsx, TM4C123G_connectors.sch]
2014-08-06 Cambiato logo OSHW con il logo TI lauchpad
    [TM4C123G_CommExpBoard.kicad_pcb]
2014-08-06 Aggiornamento revisione su serigrafia scheda (0.3 invece di 1.0). La revisione della scheda sarà la stessa del file .pcbnew
    [TM4C123G_CommExpBoard.kicad_pcb, TM4C123G_CommExpBoard_BOM.xlsx]
2014-08-06 Modificato il nome di P10 GPIO0 al posto di EB_GPIO0 e schematico rinominato in rev.0.3.4; di conseguenza è stato rinominato il valore di P10 anche sul PCB. Aggiornate le serigrafie dei connettori su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
    [Expansion_board.sch, TM4C123G_CommExpBoard.kicad_pcb, TM4C123G_CommExpBoard.sch, TM4C123G_connectors.sch]
2014-08-07 Schema elettrico: variate le connessione del partitore di fail-safe-biasing. R13 è di pull-down ed R15 di pull-up, quindi sono connesse rispettivamente verso gnd e +3.3V. In precedenza erano scambiat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
    [Expansion_board.sch, TM4C123G_CommExpBoard.kicad_pcb, TM4C123G_CommExpBoard.sch, TM4C123G_connectors.sch]
2014-10-03 Aggiornamenti minori, aggiunta della cartella FW e documentazione TolhNet.
    [Expansion_board.sch, TM4C123G_CommExpBoard.sch, TM4C123G_connectors.sch]
2014-10-04 - sostituiti i pad smd dell'antenna con due pad through hole; - ridotto il numero di vias sottostanti il modulo radio RFM23B e spostati i rimanenti in maniera da evitare la sovrapposizione con i vias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
    Aggiunta la cartella "PCB_fabrication" che contiene:
    - il file excel (BOM);
    - i file per le forature;
    - i file Gerber;
    - alcuni file .txt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
    [BOM_TM4C123G_CommExpBoard_v1_0.xlsx, Expansion_board.sch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]
2014-11-12 moved P1 and P5 silkscreens near relative pads.
    [TM4C123G_CommExpBoard.kicad_pcb]
2014-11-26 Update of PCB and schematic to rev 1.1 (fixed old Q3 footprint in which pins 1 and 2 were flipped and relative nets). Build new v1.1 fabrication files.
    [Expansion_board.sch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]
2015-01-09 Added a new project: CAN_drv_example in order to develop drivers for CAN peripheral. It was derived by GPIO_example.
2015-01-12 Developed GPIO_eaxample project. Now the interrupt is working in either mode: - static allocation into interrupt vector table - dynamic allocation into interrupt vector table through function IntRegi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
    The PF0 pin, locked because it is a NMI pin, was unlocked.
2015-01-12 Updated GPIO_example project with UART transmission.
    Updated all project with proper Symbol definition (PART_TM4C123GH6PM). In past there was a wrong definition!
    [main.c, my_uart.c, my_uart.h]
2015-01-13 Developed CAN_drv: now there is some activity over the CAN bus.
2015-01-16 New verion of CAN_drv_TX_example. New logic to handle connection error. Now it's strongest regarding connection errors.
    [app_can.c, main.c]
2015-01-16 New verion of CAN_drv_RX_example. New logic to handle connection error. Now it's strongest regarding connection errors. Still some trouble after about 5 minutes of working. Tx device seems it stop to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
    [main.c]
2015-01-19 Interrupt disabling applied on (and only on) CAN_drv_TX_example. Now the interrupt is disabled into ISR and re-enabled into CAN BUS handling stuffs into main.c
2015-01-22 Working example showed to Professor. All went well. Interrupt disabling applied on (and only on) CAN_drv_TX_example. Now the interrupt is disabled into ISR and re-enabled into CAN BUS handling stuffs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
2015-01-24 Added a new project. It seems it work! Fix uartprintf into canhandler!
    [app_can.c, app_can.h, main.c, my_uart.c, my_uart.h, rgb.c, rgb.h, startup_gcc.c]
2015-01-25 minor changes: now multiTX not TX >4 packets. Probably ther's an error into "void app_can_SendMultipleMsg(const uint64_t* pui64_msg, const uint16_t msg_length)"
    [main.c]
2015-01-25 multiTx seems working but UARTprintf work only first time it was called. Why?
